kevinjuszczyk/SuperXBit192/kicad/badgesao.step

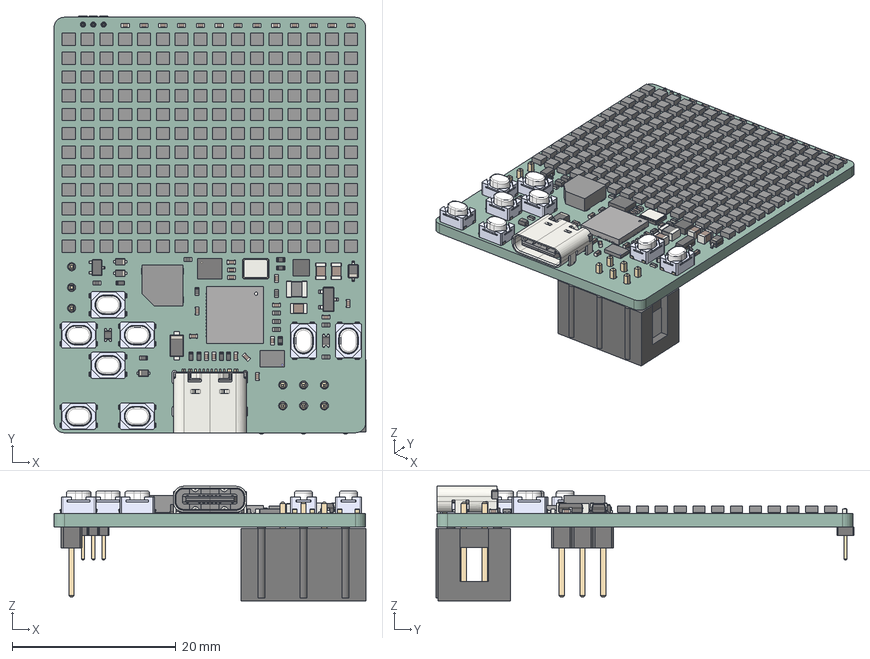
[picture p1: CAD file, 2024-10-02]
kicad/badgesao.step
38.1 x 51.1 x 14.0 mm
ASSEMBLY x 193
C_0402_1005Metric x 28
W25Q80EWUXIE
PTS810SJK250SMTR LFS x 8
R_0402_1005Metric x 18
D_SOD_123F
L_1008_2520Metric
D_SOD_523 x 3
USB_C_Receptacle_16P_TopMnt_Horizontal_GCT_USB4105-xx-A
C_0805_2012Metric x 3
Crystal_SMD_SeikoEpson_FA238-4Pin_3.2x2.5mm
LGA_14_3x25mm_P05mm_LayoutBorder3x4y
SOT_23
TPS61022RWUR
SOT_323_SC_70
QFN_56_1EP_7x7mm_P04mm_EP32x32mm
D_0603 x 2
D_SOD_323
IDC_Header_2x03_P254mm_Vertical
PinHeader_1x03_P254mm_Vertical
PinHeader_1x03_P127mm_Vertical
badgesao_PCB
