kevinjuszczyk/SuperXBit192/kicad/SuperXBit192_schematic.pdf

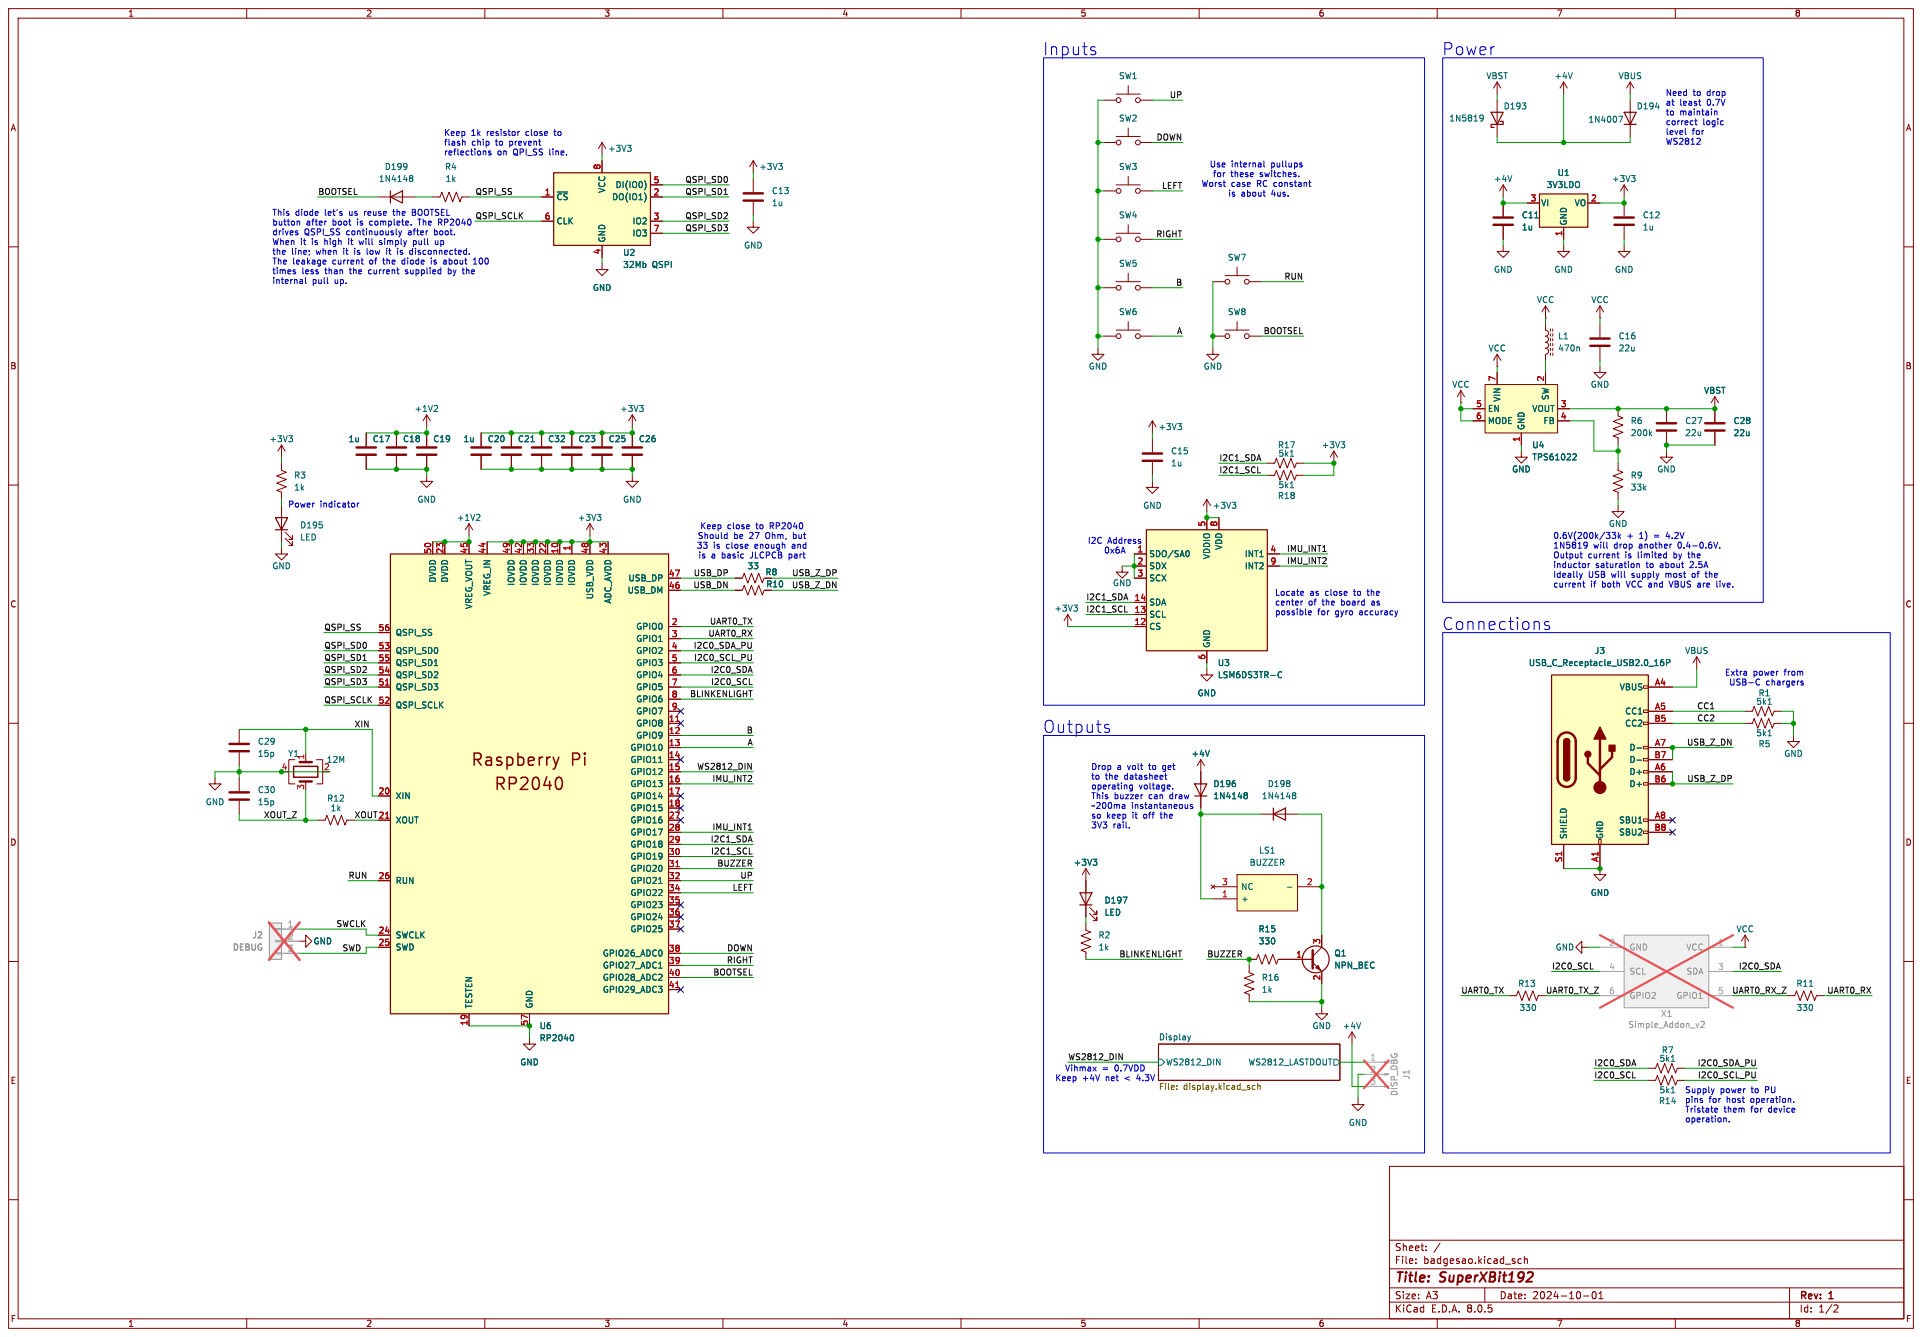
[picture p2: page 1]

Inputs
is about 4us. Locate as close to the
RIGHTB

for these switches. Worst case RC constant

This diode let's us reuse the BOOTSEL

the line; when it is low it is disconnected. The leakage current of the diode is about 100

Ideally USB will supply most of the
current if both VCC and VBUS are live.

~200ma instantaneous
so keep it off the

I2C0_SDA_PU
I2C0_SCL_PU
Supply power to PU
pins for host operation. Tristate them for device
operation.

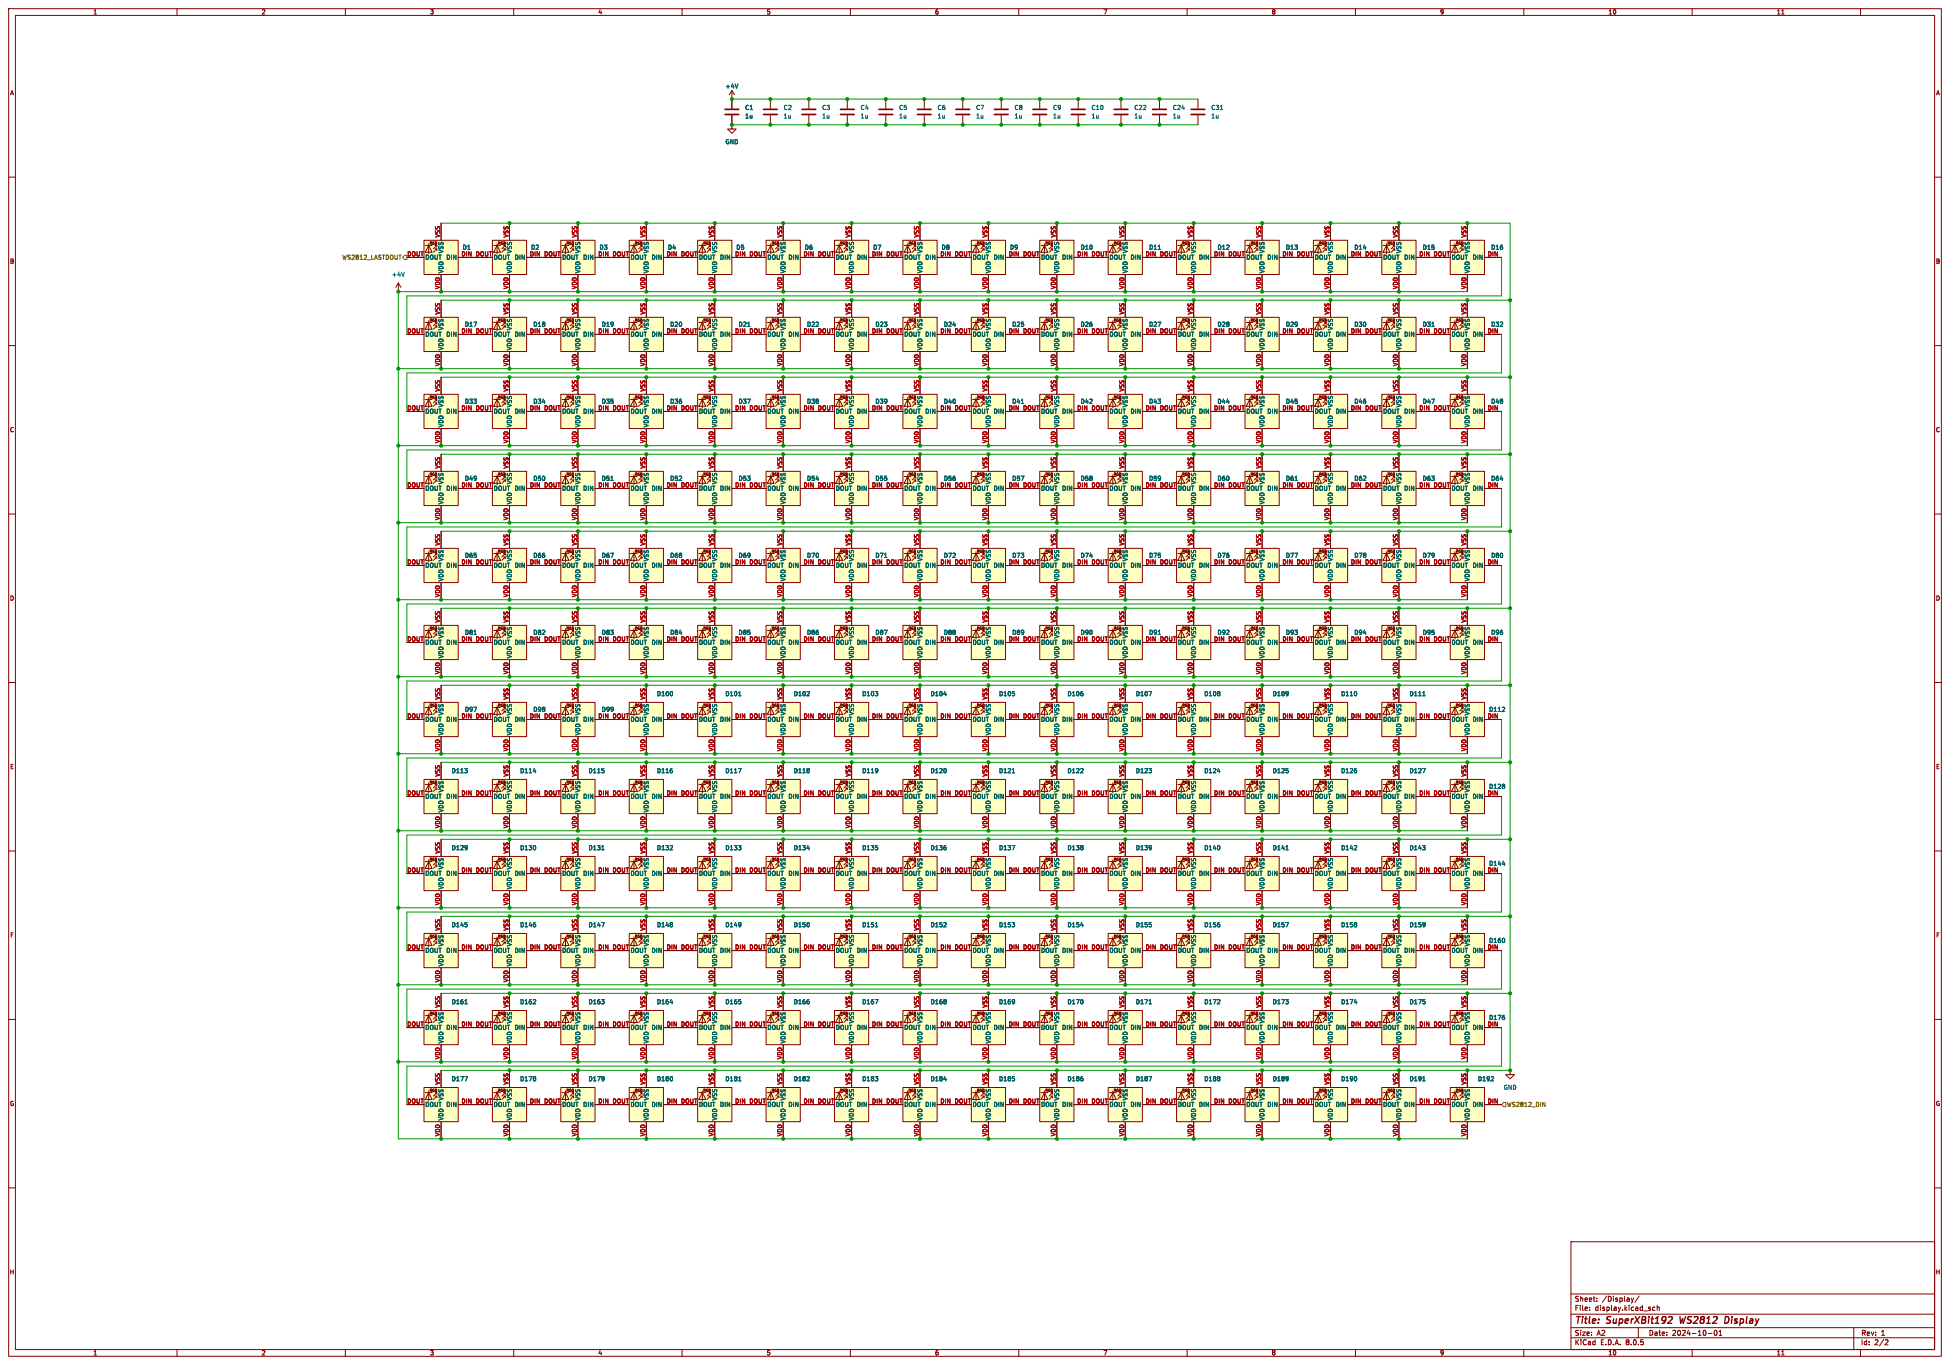
[picture p3: page 2]

File: display.kicad_sch Sheet: /Display/
