kevinjuszczyk/SuperXBit192/kicad/badgesao.kicad_pcb

## KiCad design kicad/badgesao.kicad_pcb (2024-10-02)

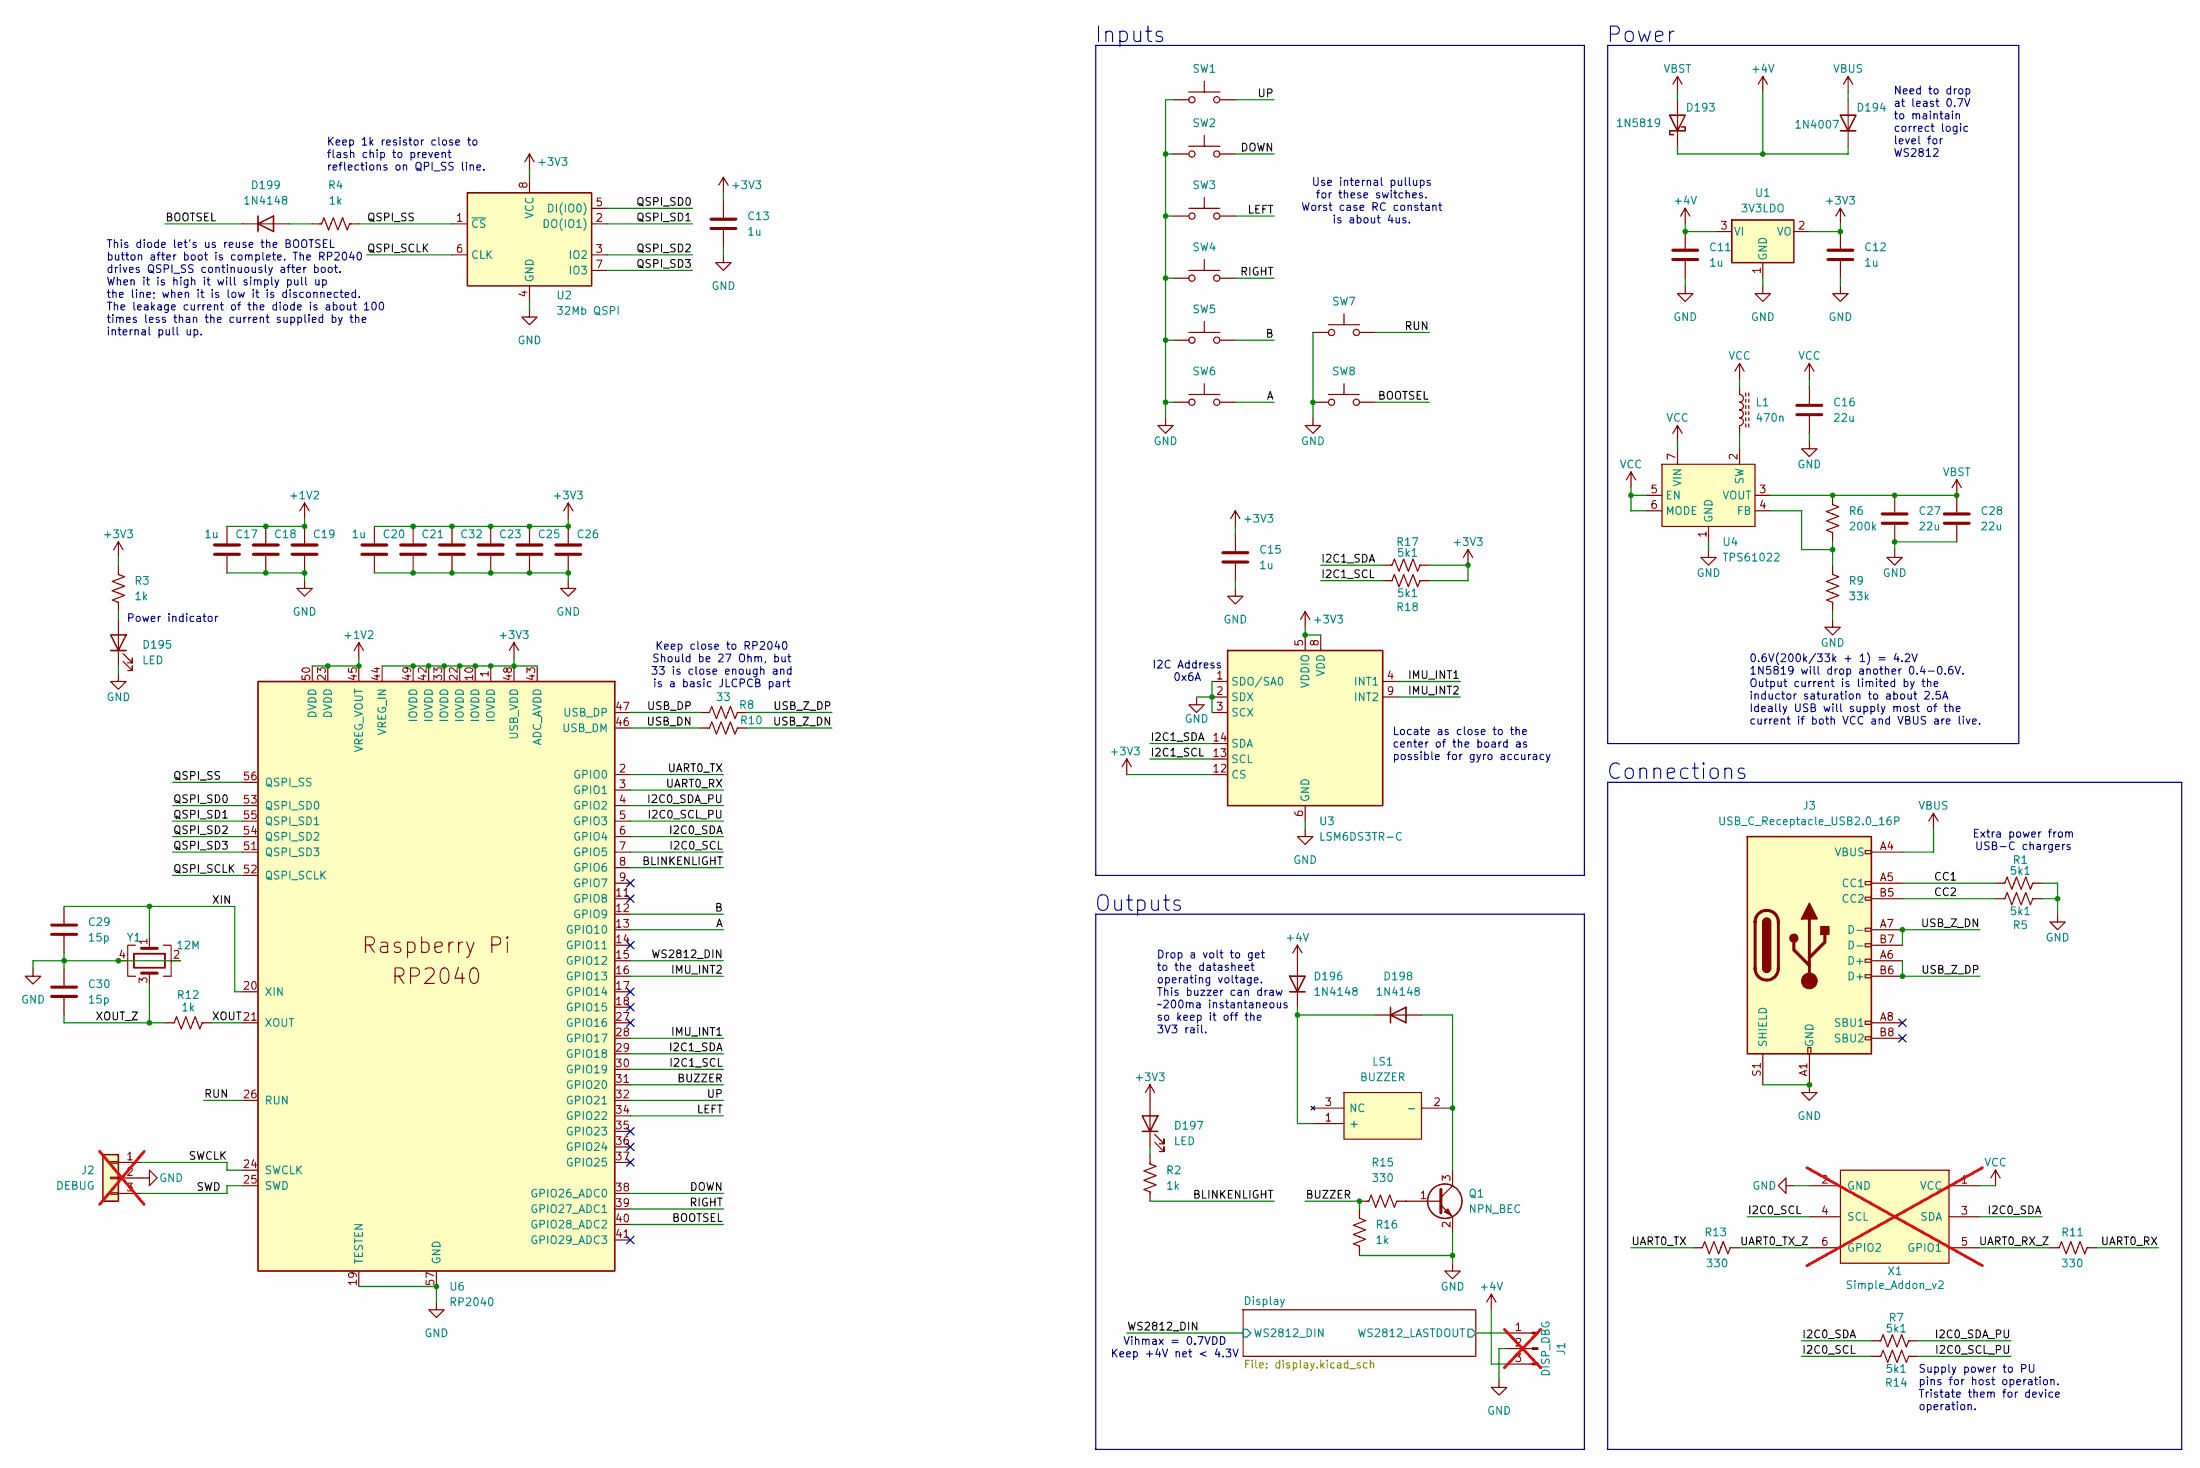
[picture p4: schematic badgesao.kicad_sch, SuperXBit192]

Parts:
C11, C12, C13, C15, C17, C18, C19, C20, C21, C23, C25, C26, C32: 1u; C_0402_1005Metric; Manufacturer_Part_Number CL05A105KA5NQNC; LCSC C52923
C16, C27, C28: 22u; C_0805_2012Metric; Manufacturer_Part_Number CL21A226MAQNNNE; LCSC C45783
C29, C30: 15p; C_0402_1005Metric; Manufacturer_Part_Number 0402CG150J500NT; LCSC C1548
D193: 1N5819; D_SOD-323; Manufacturer_Part_Number 1N5819WS; LCSC C191023
D194: 1N4007; D_SOD-123F; Manufacturer_Part_Number SM4007PL; LCSC C64898
D195, D197: LED; D_0603_1608Metric; Manufacturer_Part_Number KT-0603R; LCSC C2286
D196, D198, D199: 1N4148; D_SOD-523; Manufacturer_Part_Number 1N4148WT; LCSC C7420320
J1: DISP_DBG; PinHeader_1x03_P1.27mm_Vertical; Manufacturer_Part_Number M50-3530342; Digikey_Part 952-3599-ND; not fitted
J2: DEBUG; PinHeader_1x03_P2.54mm_Vertical; Manufacturer_Part_Number 61300311121; Digikey_Part 732-5316-ND; not fitted
J3: USB_C_Receptacle_USB2.0_16P; USB_C_Receptacle_GCT_USB4105-xx-A_16P_TopMnt_Horizontal; Manufacturer_Part_Number U263-163N-4BLS1735; LCSC C2931474
L1: 470n; L_1008_2520Metric; Manufacturer_Part_Number 1239AS-H-R47M=P2; LCSC C576393
LS1: BUZZER; CMT5023SSMTTR; Manufacturer_Part_Number FUET-5020; LCSC C391029
Q1: NPN_BEC; SOT-323_SC-70; Manufacturer_Part_Number MMST3904; LCSC C22388837
R1, R5, R7, R14, R17, R18: 5k1; R_0402_1005Metric; Manufacturer_Part_Number 0402WGF5101TCE; LCSC C25905
R2, R3, R4, R12, R16: 1k; R_0402_1005Metric; Manufacturer_Part_Number 0402WGF1001TCE; LCSC C11702
R6: 200k; R_0402_1005Metric; Manufacturer_Part_Number 0402WGF2003TCE; LCSC C25764
R8, R10: 33; R_0402_1005Metric; Manufacturer_Part_Number 0402WGF330JTCE; LCSC C25105
R9: 33k; R_0402_1005Metric; Manufacturer_Part_Number 0402WGF3302TCE; LCSC C25779
R11, R13, R15: 330; R_0402_1005Metric; Manufacturer_Part_Number 0402WGF3300TCE; LCSC C25104
SW1: UP; SW_SPST_PTS810; Manufacturer_Part_Number PTS815SJM250SMTRLFS; LCSC C2689510
SW2: DOWN; SW_SPST_PTS810; Manufacturer_Part_Number PTS815SJM250SMTRLFS; LCSC C2689510
SW3: LEFT; SW_SPST_PTS810; Manufacturer_Part_Number PTS815SJM250SMTRLFS; LCSC C2689510
SW4: RIGHT; SW_SPST_PTS810; Manufacturer_Part_Number PTS815SJM250SMTRLFS; LCSC C2689510
SW5: B; SW_SPST_PTS810; Manufacturer_Part_Number PTS815SJM250SMTRLFS; LCSC C2689510
SW6: A; SW_SPST_PTS810; Manufacturer_Part_Number PTS815SJM250SMTRLFS; LCSC C2689510
SW7: RESET; SW_SPST_PTS810; Manufacturer_Part_Number PTS815SJM250SMTRLFS; LCSC C2689510
SW8: BOOTSEL; SW_SPST_PTS810; Manufacturer_Part_Number PTS815SJM250SMTRLFS; LCSC C2689510
U1: 3V3LDO; SOT-23; Manufacturer_Part_Number XC6206P332MR-G; LCSC C5446
U2: 32Mb QSPI; Winbond_USON-8-1EP_3x2mm_P0.5mm_EP0.2x1.6mm; Manufacturer_Part_Number ZD25WQ32CEIGR; LCSC C5258281
U3: LSM6DS3TR-C; LGA-14_3x2.5mm_P0.5mm_LayoutBorder3x4y; Manufacturer_Part_Number LSM6DS3TR-C; LCSC C967633
U4: TPS61022; Texas_RWU0007A_VQFN-7_2x2mm_P0.5mm; Manufacturer_Part_Number TPS61022RWUR; LCSC C915088
U6: RP2040; QFN-56-1EP_7x7mm_P0.4mm_EP3.2x3.2mm; Manufacturer_Part_Number RP2040; LCSC C2040
X1: Simple_Addon_v2; Simple_Addon_v2-SAO-2x3; Manufacturer_Part_Number 75869-131LF; Digikey_Part 609-2845-ND; not fitted
Y1: 12M; Crystal_SMD_SeikoEpson_FA238-4Pin_3.2x2.5mm; Manufacturer_Part_Number X322512MSB4SI; LCSC C9002

Connections:
+1V2: C17.1, C18.1, C19.1, U6.23 (DVDD), U6.45 (VREG_VOUT), U6.50 (DVDD)
+3V3: C12.1, C13.1, C15.1, C20.1, C21.1, C23.1, C25.1, C26.1, C32.1, D197.2 (A), R3.2, R17.1, R18.1, U1.2 (VO), U2.8 (VCC), U3.5 (VDDIO), U3.8 (VDD), U3.12 (CS), U6.1 (IOVDD), U6.10 (IOVDD), U6.22 (IOVDD), U6.33 (IOVDD), U6.42 (IOVDD), U6.43 (ADC_AVDD), U6.44 (VREG_IN), U6.48 (USB_VDD), U6.49 (IOVDD)
+4V: C11.1, D193.1 (K), D194.1 (K), D196.2 (A), J1.3, U1.3 (VI); also elsewhere on the board
/A: SW6.2, U6.13 (GPIO10)
/B: SW5.2, U6.12 (GPIO9)
/BLINKENLIGHT: R2.1, U6.8 (GPIO6)
/BOOTSEL: D199.1 (K), SW8.2, U6.40 (GPIO28_ADC2)
/BUZZER: R15.2, R16.2, U6.31 (GPIO20)
/CC1: J3.A5 (CC1), R1.2
/CC2: J3.B5 (CC2), R5.2
/DOWN: SW2.2, U6.38 (GPIO26_ADC0)
/Display/WS2812_LASTDOUT: J1.1; also elsewhere on the board
/I2C0_SCL: R14.2, U6.7 (GPIO5), X1.4 (SCL)
/I2C0_SCL_PU: R14.1, U6.5 (GPIO3)
/I2C0_SDA: R7.2, U6.6 (GPIO4), X1.3 (SDA)
/I2C0_SDA_PU: R7.1, U6.4 (GPIO2)
/I2C1_SCL: R18.2, U3.13 (SCL), U6.30 (GPIO19)
/I2C1_SDA: R17.2, U3.14 (SDA), U6.29 (GPIO18)
/IMU_INT1: U3.4 (INT1), U6.28 (GPIO17)
/IMU_INT2: U3.9 (INT2), U6.16 (GPIO13)
/LEFT: SW3.2, U6.34 (GPIO22)
/QSPI_SCLK: U2.6 (CLK), U6.52 (QSPI_SCLK)
/QSPI_SD0: U2.5 (DI(IO0)), U6.53 (QSPI_SD0)
/QSPI_SD1: U2.2 (DO(IO1)), U6.55 (QSPI_SD1)
/QSPI_SD2: U2.3 (IO2), U6.54 (QSPI_SD2)
/QSPI_SD3: U2.7 (IO3), U6.51 (QSPI_SD3)
/QSPI_SS: R4.1, U2.1 (~CS), U6.56 (QSPI_SS)
/RIGHT: SW4.2, U6.39 (GPIO27_ADC1)
/RUN: SW7.2, U6.26 (RUN)
/SWCLK: J2.1, U6.24 (SWCLK)
/SWD: J2.3, U6.25 (SWD)
/UART0_RX: R11.2, U6.3 (GPIO1)
/UART0_RX_Z: R11.1, X1.5 (GPIO1)
/UART0_TX: R13.1, U6.2 (GPIO0)
/UART0_TX_Z: R13.2, X1.6 (GPIO2)
/UP: SW1.2, U6.32 (GPIO21)
/USB_DN: R10.2, U6.46 (USB_DM)
/USB_DP: R8.2, U6.47 (USB_DP)
/USB_Z_DN: J3.A7 (D-), J3.B7 (D-), R10.1
/USB_Z_DP: J3.A6 (D+), J3.B6 (D+), R8.1
/WS2812_DIN: U6.15 (GPIO12); also elsewhere on the board
/XIN: C29.1, U6.20 (XIN), Y1.1
/XOUT: R12.1, U6.21 (XOUT)
/XOUT_Z: C30.2, R12.2, Y1.3
GND: C11.2, C12.2, C13.2, C15.2, C16.2, C17.2, C18.2, C19.2, C20.2, C21.2, C23.2, C25.2, C26.2, C27.2, C28.2, C29.2, C30.1, C32.2, D195.1 (K), J1.2, J2.2, J3.A1 (GND), J3.A12 (GND), J3.B1 (GND), J3.B12 (GND), J3.S1 (SHIELD), Q1.2 (E), R1.1, R5.1, R9.2, R16.1, SW1.1, SW2.1, SW3.1, SW4.1, SW5.1, SW6.1, SW7.1, SW8.1, U1.1 (GND), U2.4 (GND), U3.1 (SDO/SA0), U3.2 (SDX), U3.3 (SCX), U3.6 (GND), U3.7 (GND), U4.1 (GND), U6.19 (TESTEN), U6.57 (GND), X1.2 (GND), Y1.2, Y1.4; also elsewhere on the board
unnamed: D195.2 (A), R3.1
unnamed: D196.1 (K), D198.1 (K), LS1.1 (+)
unnamed: D197.1 (K), R2.2
unnamed: D198.2 (A), LS1.2 (-), Q1.3 (C)
unnamed: D199.2 (A), R4.2
unnamed: Q1.1 (B), R15.1
unnamed: R6.2, R9.1, U4.4 (FB)
unnamed: L1.2, U4.2 (SW)
VBST: C27.1, C28.1, D193.2 (A), R6.1, U4.3 (VOUT)
VBUS: D194.2 (A), J3.A4 (VBUS), J3.A9 (VBUS), J3.B4 (VBUS), J3.B9 (VBUS)
VCC: C16.1, L1.1, U4.5 (EN), U4.6 (MODE), U4.7 (VIN), X1.1 (VCC)

Notes on the sheet:
This diode let's us reuse the BOOTSEL button after boot is complete. The RP2040 drives QSPI_SS continuously after boot. When it is high it will simply pull up the line; when it is low it is disconnected. The leakage current of the diode is about 100 times less than the current supplied by the inter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
0.6V(200k/33k + 1) = 4.2V 1N5819 will drop another 0.4-0.6V. Output current is limited by the inductor saturation to about 2.5A Ideally USB will supply most of the current if both VCC and VBUS are live.
Need to drop at least 0.7V to maintain correct logic level for WS2812
Inputs
Extra power from USB-C chargers
Connections
Drop a volt to get to the datasheet operating voltage. This buzzer can draw ~200ma instantaneous so keep it off the 3V3 rail.
Power
Supply power to PU pins for host operation. Tristate them for device operation.
Outputs
Power indicator
Vihmax = 0.7VDD Keep +4V net < 4.3V
Keep 1k resistor close to flash chip to prevent reflections on QPI_SS line.
I2C Address 0x6A
Use internal pullups for these switches. Worst case RC constant is about 4us.
Keep close to RP2040 Should be 27 Ohm, but 33 is close enough and is a basic JLCPCB part
Locate as close to the center of the board as possible for gyro accuracy

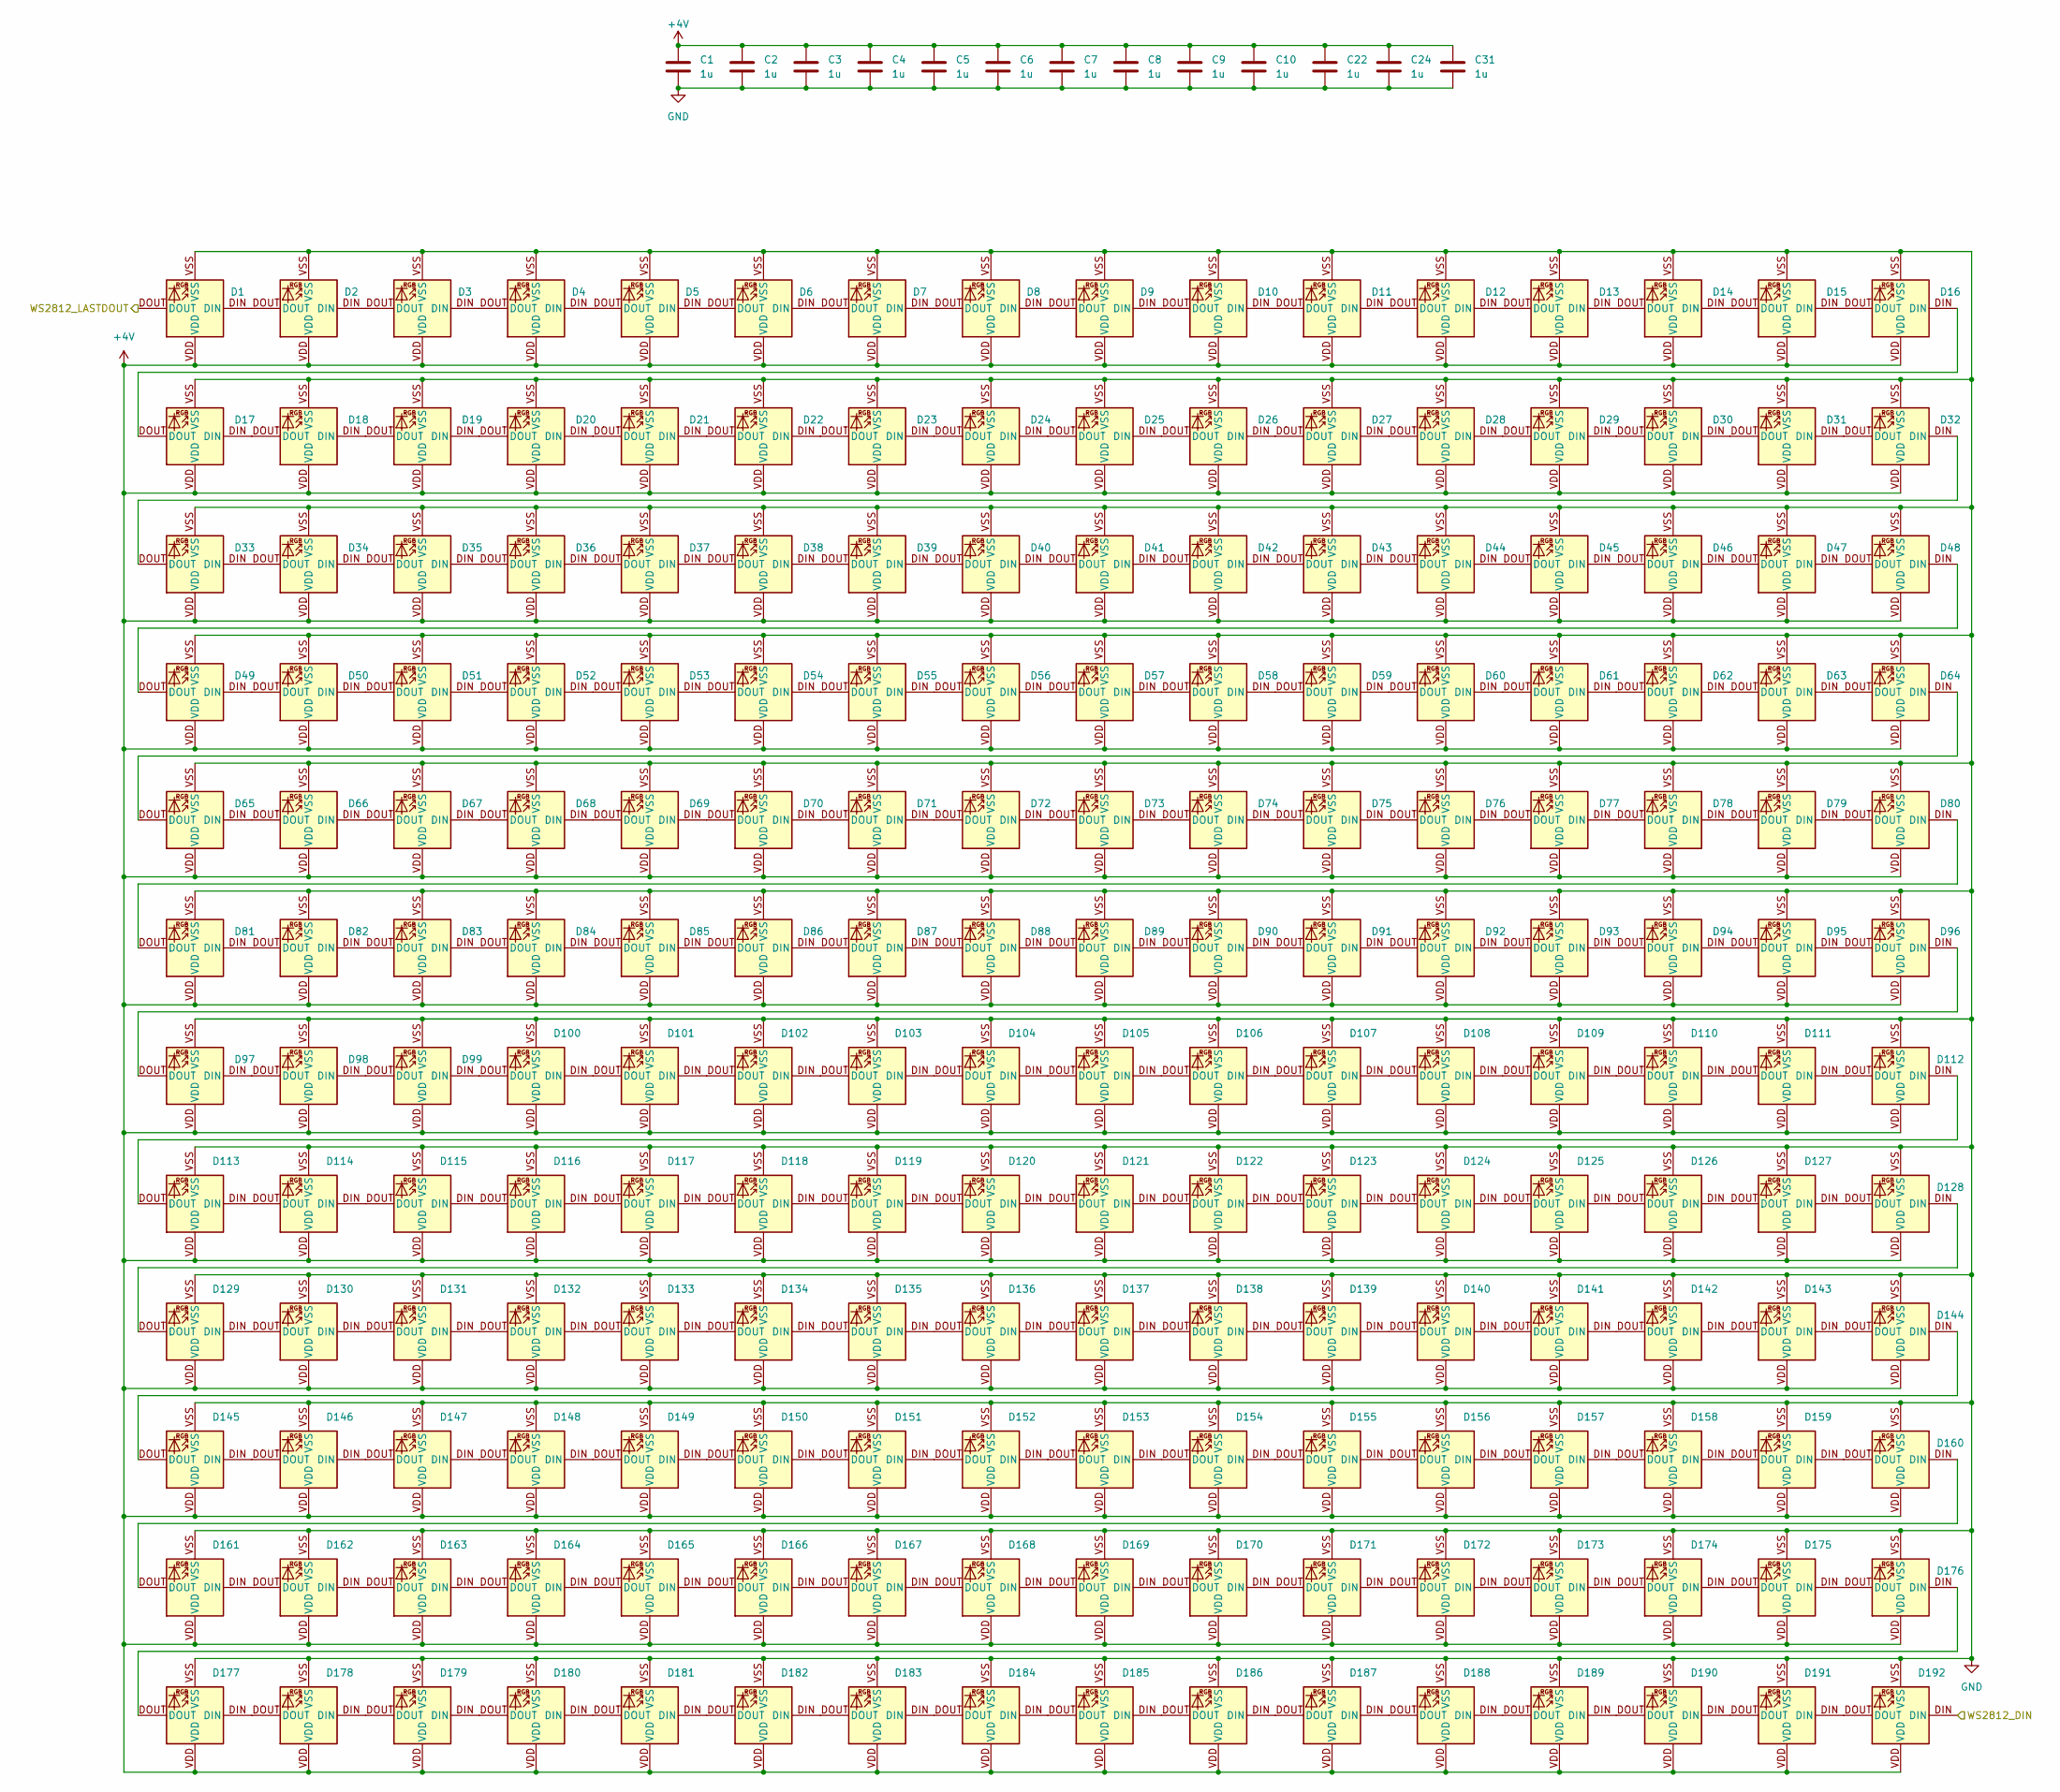
[picture p5: schematic display.kicad_sch, SuperXBit192 WS2812 Display]

Parts:
C1, C2, C3, C4, C5, C6, C7, C8, C9, C10, C22, C24, C31: 1u; C_0402_1005Metric; Manufacturer_Part_Number CL05A105KA5NQNC; LCSC C52923
D1, D2, D3, D4, D5, D6, D7, D8, D9, D10, D11, D12, D13, D14, D15, D16, D17, D18, D19, D20, D21, D22, D23, D24, D25, D26, D27, D28, D29, D30, D31, D32, D33, D34, D35, D36, D37, D38, D39, D40, D41, D42, D43, D44, D45, D46, D47, D48, D49, D50, D51, D52, D53, D54, D55, D56, D57, D58, D59, D60, D61, D62, D63, D64, D65, D66, D67, D68, D69, D70, D71, D72, D73, D74, D75, D76, D77, D78, D79, D80, D81, D82, D83, D84, D85, D86, D87, D88, D89, D90, D91, D92, D93, D94, D95, D96, D97, D98, D99, D100, D101, D102, D103, D104, D105, D106, D107, D108, D109, D110, D111, D112, D113, D114, D115, D116, D117, D118, D119, D120, D121, D122, D123, D124, D125, D126, D127, D128, D129, D130, D131, D132, D133, D134, D135, D136, D137, D138, D139, D140, D141, D142, D143, D144, D145, D146, D147, D148, D149, D150, D151, D152, D153, D154, D155, D156, D157, D158, D159, D160, D161, D162, D163, D164, D165, D166, D167, D168, D169, D170, D171, D172, D173, D174, D175, D176, D177, D178, D179, D180, D181, D182, D183, D184, D185, D186, D187, D188, D189, D190, D191, D192: WS2812B; LED_WS2812B-1615_PLCC4_1.6x1.5mm; Manufacturer_Part_Number XL-1615RGBC-WS2812B; LCSC C5349954

Connections:
+4V: C1.1, C2.1, C3.1, C4.1, C5.1, C6.1, C7.1, C8.1, C9.1, C10.1, C22.1, C24.1, C31.1, D1.VDD, D2.VDD, D3.VDD, D4.VDD, D5.VDD, D6.VDD, D7.VDD, D8.VDD, D9.VDD, D10.VDD, D11.VDD, D12.VDD, D13.VDD, D14.VDD, D15.VDD, D16.VDD, D17.VDD, D18.VDD, D19.VDD, D20.VDD, D21.VDD, D22.VDD, D23.VDD, D24.VDD, D25.VDD, D26.VDD, D27.VDD, D28.VDD, D29.VDD, D30.VDD, D31.VDD, D32.VDD, D33.VDD, D34.VDD, D35.VDD, D36.VDD, D37.VDD, D38.VDD, D39.VDD, D40.VDD, D41.VDD, D42.VDD, D43.VDD, D44.VDD, D45.VDD, D46.VDD, D47.VDD, D48.VDD, D49.VDD, D50.VDD, D51.VDD, D52.VDD, D53.VDD, D54.VDD, D55.VDD, D56.VDD, D57.VDD, D58.VDD, D59.VDD, D60.VDD, D61.VDD, D62.VDD, D63.VDD, D64.VDD, D65.VDD, D66.VDD, D67.VDD, D68.VDD, D69.VDD, D70.VDD, D71.VDD, D72.VDD, D73.VDD, D74.VDD, D75.VDD, D76.VDD, D77.VDD, D78.VDD, D79.VDD, D80.VDD, D81.VDD, D82.VDD, D83.VDD, D84.VDD, D85.VDD, D86.VDD, D87.VDD, D88.VDD, D89.VDD, D90.VDD, D91.VDD, D92.VDD, D93.VDD, D94.VDD, D95.VDD, D96.VDD, D97.VDD, D98.VDD, D99.VDD, D100.VDD, D101.VDD, D102.VDD, D103.VDD, D104.VDD, D105.VDD, D106.VDD, D107.VDD, D108.VDD, D109.VDD, D110.VDD, D111.VDD, D112.VDD, D113.VDD, D114.VDD, D115.VDD, D116.VDD, D117.VDD, D118.VDD, D119.VDD, D120.VDD, D121.VDD, D122.VDD, D123.VDD, D124.VDD, D125.VDD, D126.VDD, D127.VDD, D128.VDD, D129.VDD, D130.VDD, D131.VDD, D132.VDD, D133.VDD, D134.VDD, D135.VDD, D136.VDD, D137.VDD, D138.VDD, D139.VDD, D140.VDD, D141.VDD, D142.VDD, D143.VDD, D144.VDD, D145.VDD, D146.VDD, D147.VDD, D148.VDD, D149.VDD, D150.VDD, D151.VDD, D152.VDD, D153.VDD, D154.VDD, D155.VDD, D156.VDD, D157.VDD, D158.VDD, D159.VDD, D160.VDD, D161.VDD, D162.VDD, D163.VDD, D164.VDD, D165.VDD, D166.VDD, D167.VDD, D168.VDD, D169.VDD, D170.VDD, D171.VDD, D172.VDD, D173.VDD, D174.VDD, D175.VDD, D176.VDD, D177.VDD, D178.VDD, D179.VDD, D180.VDD, D181.VDD, D182.VDD, D183.VDD, D184.VDD, D185.VDD, D186.VDD, D187.VDD, D188.VDD, D189.VDD, D190.VDD, D191.VDD, D192.VDD; also elsewhere on the board
/Display/WS2812_LASTDOUT: D1.DOUT; also elsewhere on the board
/WS2812_DIN: D192.DIN; also elsewhere on the board
GND: C1.2, C2.2, C3.2, C4.2, C5.2, C6.2, C7.2, C8.2, C9.2, C10.2, C22.2, C24.2, C31.2, D1.VSS, D2.VSS, D3.VSS, D4.VSS, D5.VSS, D6.VSS, D7.VSS, D8.VSS, D9.VSS, D10.VSS, D11.VSS, D12.VSS, D13.VSS, D14.VSS, D15.VSS, D16.VSS, D17.VSS, D18.VSS, D19.VSS, D20.VSS, D21.VSS, D22.VSS, D23.VSS, D24.VSS, D25.VSS, D26.VSS, D27.VSS, D28.VSS, D29.VSS, D30.VSS, D31.VSS, D32.VSS, D33.VSS, D34.VSS, D35.VSS, D36.VSS, D37.VSS, D38.VSS, D39.VSS, D40.VSS, D41.VSS, D42.VSS, D43.VSS, D44.VSS, D45.VSS, D46.VSS, D47.VSS, D48.VSS, D49.VSS, D50.VSS, D51.VSS, D52.VSS, D53.VSS, D54.VSS, D55.VSS, D56.VSS, D57.VSS, D58.VSS, D59.VSS, D60.VSS, D61.VSS, D62.VSS, D63.VSS, D64.VSS, D65.VSS, D66.VSS, D67.VSS, D68.VSS, D69.VSS, D70.VSS, D71.VSS, D72.VSS, D73.VSS, D74.VSS, D75.VSS, D76.VSS, D77.VSS, D78.VSS, D79.VSS, D80.VSS, D81.VSS, D82.VSS, D83.VSS, D84.VSS, D85.VSS, D86.VSS, D87.VSS, D88.VSS, D89.VSS, D90.VSS, D91.VSS, D92.VSS, D93.VSS, D94.VSS, D95.VSS, D96.VSS, D97.VSS, D98.VSS, D99.VSS, D100.VSS, D101.VSS, D102.VSS, D103.VSS, D104.VSS, D105.VSS, D106.VSS, D107.VSS, D108.VSS, D109.VSS, D110.VSS, D111.VSS, D112.VSS, D113.VSS, D114.VSS, D115.VSS, D116.VSS, D117.VSS, D118.VSS, D119.VSS, D120.VSS, D121.VSS, D122.VSS, D123.VSS, D124.VSS, D125.VSS, D126.VSS, D127.VSS, D128.VSS, D129.VSS, D130.VSS, D131.VSS, D132.VSS, D133.VSS, D134.VSS, D135.VSS, D136.VSS, D137.VSS, D138.VSS, D139.VSS, D140.VSS, D141.VSS, D142.VSS, D143.VSS, D144.VSS, D145.VSS, D146.VSS, D147.VSS, D148.VSS, D149.VSS, D150.VSS, D151.VSS, D152.VSS, D153.VSS, D154.VSS, D155.VSS, D156.VSS, D157.VSS, D158.VSS, D159.VSS, D160.VSS, D161.VSS, D162.VSS, D163.VSS, D164.VSS, D165.VSS, D166.VSS, D167.VSS, D168.VSS, D169.VSS, D170.VSS, D171.VSS, D172.VSS, D173.VSS, D174.VSS, D175.VSS, D176.VSS, D177.VSS, D178.VSS, D179.VSS, D180.VSS, D181.VSS, D182.VSS, D183.VSS, D184.VSS, D185.VSS, D186.VSS, D187.VSS, D188.VSS, D189.VSS, D190.VSS, D191.VSS, D192.VSS; also elsewhere on the board
unnamed: D1.DIN, D2.DOUT
unnamed: D2.DIN, D3.DOUT
unnamed: D3.DIN, D4.DOUT
unnamed: D4.DIN, D5.DOUT
unnamed: D5.DIN, D6.DOUT
unnamed: D6.DIN, D7.DOUT
unnamed: D7.DIN, D8.DOUT
unnamed: D8.DIN, D9.DOUT
unnamed: D10.DIN, D11.DOUT
unnamed: D9.DIN, D10.DOUT
unnamed: D11.DIN, D12.DOUT
unnamed: D12.DIN, D13.DOUT
unnamed: D13.DIN, D14.DOUT
unnamed: D14.DIN, D15.DOUT
unnamed: D15.DIN, D16.DOUT
unnamed: D16.DIN, D17.DOUT
unnamed: D17.DIN, D18.DOUT
unnamed: D18.DIN, D19.DOUT
unnamed: D19.DIN, D20.DOUT
unnamed: D20.DIN, D21.DOUT
unnamed: D21.DIN, D22.DOUT
unnamed: D22.DIN, D23.DOUT
unnamed: D23.DIN, D24.DOUT
unnamed: D24.DIN, D25.DOUT
unnamed: D25.DIN, D26.DOUT
unnamed: D26.DIN, D27.DOUT
unnamed: D27.DIN, D28.DOUT
unnamed: D28.DIN, D29.DOUT
unnamed: D29.DIN, D30.DOUT
unnamed: D30.DIN, D31.DOUT
unnamed: D31.DIN, D32.DOUT
unnamed: D32.DIN, D33.DOUT
unnamed: D33.DIN, D34.DOUT
unnamed: D34.DIN, D35.DOUT
unnamed: D35.DIN, D36.DOUT
unnamed: D36.DIN, D37.DOUT
unnamed: D37.DIN, D38.DOUT
unnamed: D38.DIN, D39.DOUT
unnamed: D39.DIN, D40.DOUT
unnamed: D40.DIN, D41.DOUT
unnamed: D41.DIN, D42.DOUT
unnamed: D42.DIN, D43.DOUT
unnamed: D43.DIN, D44.DOUT
unnamed: D44.DIN, D45.DOUT
unnamed: D45.DIN, D46.DOUT
unnamed: D46.DIN, D47.DOUT
unnamed: D47.DIN, D48.DOUT
unnamed: D48.DIN, D49.DOUT
unnamed: D49.DIN, D50.DOUT
unnamed: D50.DIN, D51.DOUT
unnamed: D51.DIN, D52.DOUT
unnamed: D52.DIN, D53.DOUT
unnamed: D53.DIN, D54.DOUT
unnamed: D54.DIN, D55.DOUT
unnamed: D55.DIN, D56.DOUT
unnamed: D56.DIN, D57.DOUT
unnamed: D57.DIN, D58.DOUT
unnamed: D58.DIN, D59.DOUT
unnamed: D59.DIN, D60.DOUT
unnamed: D60.DIN, D61.DOUT
unnamed: D61.DIN, D62.DOUT
unnamed: D62.DIN, D63.DOUT
unnamed: D63.DIN, D64.DOUT
unnamed: D64.DIN, D65.DOUT
unnamed: D65.DIN, D66.DOUT
unnamed: D66.DIN, D67.DOUT
unnamed: D67.DIN, D68.DOUT
unnamed: D68.DIN, D69.DOUT
unnamed: D69.DIN, D70.DOUT
unnamed: D70.DIN, D71.DOUT
unnamed: D71.DIN, D72.DOUT
unnamed: D72.DIN, D73.DOUT
unnamed: D73.DIN, D74.DOUT
unnamed: D74.DIN, D75.DOUT
unnamed: D75.DIN, D76.DOUT
unnamed: D76.DIN, D77.DOUT
unnamed: D77.DIN, D78.DOUT
unnamed: D78.DIN, D79.DOUT
unnamed: D79.DIN, D80.DOUT
unnamed: D80.DIN, D81.DOUT
unnamed: D81.DIN, D82.DOUT
unnamed: D82.DIN, D83.DOUT
unnamed: D83.DIN, D84.DOUT
unnamed: D84.DIN, D85.DOUT
unnamed: D85.DIN, D86.DOUT
unnamed: D86.DIN, D87.DOUT
unnamed: D87.DIN, D88.DOUT
unnamed: D88.DIN, D89.DOUT
unnamed: D89.DIN, D90.DOUT
unnamed: D90.DIN, D91.DOUT
unnamed: D91.DIN, D92.DOUT
unnamed: D92.DIN, D93.DOUT
unnamed: D93.DIN, D94.DOUT
unnamed: D94.DIN, D95.DOUT
unnamed: D95.DIN, D96.DOUT
unnamed: D96.DIN, D97.DOUT
unnamed: D97.DIN, D98.DOUT
unnamed: D98.DIN, D99.DOUT
unnamed: D100.DIN, D101.DOUT
unnamed: D99.DIN, D100.DOUT
unnamed: D101.DIN, D102.DOUT
unnamed: D102.DIN, D103.DOUT
unnamed: D103.DIN, D104.DOUT
unnamed: D104.DIN, D105.DOUT
unnamed: D105.DIN, D106.DOUT
unnamed: D106.DIN, D107.DOUT
unnamed: D107.DIN, D108.DOUT
unnamed: D108.DIN, D109.DOUT
unnamed: D109.DIN, D110.DOUT
unnamed: D110.DIN, D111.DOUT
unnamed: D111.DIN, D112.DOUT
unnamed: D112.DIN, D113.DOUT
unnamed: D113.DIN, D114.DOUT
unnamed: D114.DIN, D115.DOUT
unnamed: D115.DIN, D116.DOUT
unnamed: D116.DIN, D117.DOUT
unnamed: D117.DIN, D118.DOUT
unnamed: D118.DIN, D119.DOUT
unnamed: D119.DIN, D120.DOUT
unnamed: D120.DIN, D121.DOUT
unnamed: D121.DIN, D122.DOUT
unnamed: D122.DIN, D123.DOUT
unnamed: D123.DIN, D124.DOUT
unnamed: D124.DIN, D125.DOUT
unnamed: D125.DIN, D126.DOUT
unnamed: D126.DIN, D127.DOUT
unnamed: D127.DIN, D128.DOUT
unnamed: D128.DIN, D129.DOUT
unnamed: D129.DIN, D130.DOUT
unnamed: D130.DIN, D131.DOUT
unnamed: D131.DIN, D132.DOUT
unnamed: D132.DIN, D133.DOUT
unnamed: D133.DIN, D134.DOUT
unnamed: D134.DIN, D135.DOUT
unnamed: D135.DIN, D136.DOUT
unnamed: D136.DIN, D137.DOUT
unnamed: D137.DIN, D138.DOUT
unnamed: D138.DIN, D139.DOUT
unnamed: D139.DIN, D140.DOUT
unnamed: D140.DIN, D141.DOUT
unnamed: D141.DIN, D142.DOUT
unnamed: D142.DIN, D143.DOUT
unnamed: D143.DIN, D144.DOUT
unnamed: D144.DIN, D145.DOUT
unnamed: D145.DIN, D146.DOUT
unnamed: D146.DIN, D147.DOUT
unnamed: D147.DIN, D148.DOUT
unnamed: D148.DIN, D149.DOUT
unnamed: D149.DIN, D150.DOUT
unnamed: D150.DIN, D151.DOUT
unnamed: D151.DIN, D152.DOUT
unnamed: D152.DIN, D153.DOUT
unnamed: D153.DIN, D154.DOUT
unnamed: D154.DIN, D155.DOUT
unnamed: D155.DIN, D156.DOUT
unnamed: D156.DIN, D157.DOUT
unnamed: D157.DIN, D158.DOUT
unnamed: D158.DIN, D159.DOUT
unnamed: D159.DIN, D160.DOUT
unnamed: D160.DIN, D161.DOUT
unnamed: D161.DIN, D162.DOUT
unnamed: D162.DIN, D163.DOUT
unnamed: D163.DIN, D164.DOUT
unnamed: D164.DIN, D165.DOUT
unnamed: D165.DIN, D166.DOUT
unnamed: D166.DIN, D167.DOUT
unnamed: D167.DIN, D168.DOUT
unnamed: D168.DIN, D169.DOUT
unnamed: D169.DIN, D170.DOUT
unnamed: D170.DIN, D171.DOUT
unnamed: D171.DIN, D172.DOUT
unnamed: D172.DIN, D173.DOUT
unnamed: D173.DIN, D174.DOUT
unnamed: D174.DIN, D175.DOUT
unnamed: D175.DIN, D176.DOUT
unnamed: D176.DIN, D177.DOUT
unnamed: D177.DIN, D178.DOUT
unnamed: D178.DIN, D179.DOUT
unnamed: D179.DIN, D180.DOUT
unnamed: D180.DIN, D181.DOUT
unnamed: D181.DIN, D182.DOUT
unnamed: D182.DIN, D183.DOUT
unnamed: D183.DIN, D184.DOUT
unnamed: D184.DIN, D185.DOUT
unnamed: D185.DIN, D186.DOUT
unnamed: D186.DIN, D187.DOUT
unnamed: D187.DIN, D188.DOUT
unnamed: D188.DIN, D189.DOUT
unnamed: D189.DIN, D190.DOUT
unnamed: D190.DIN, D191.DOUT
unnamed: D191.DIN, D192.DOUT

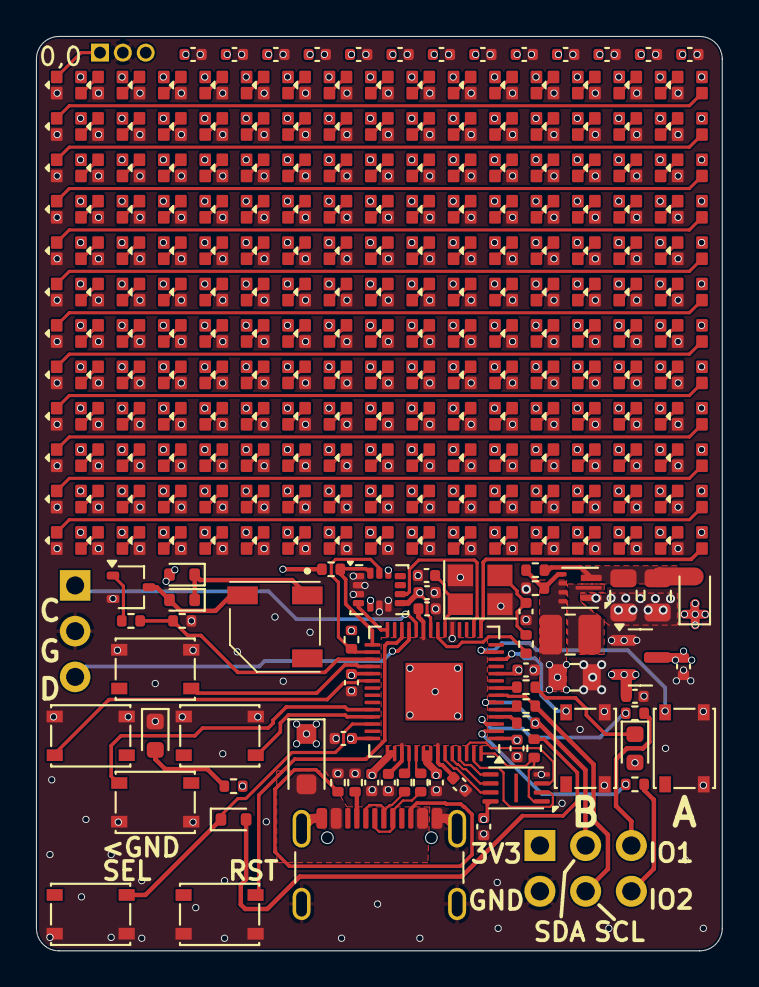
[picture p6: board badgesao.kicad_pcb from above]

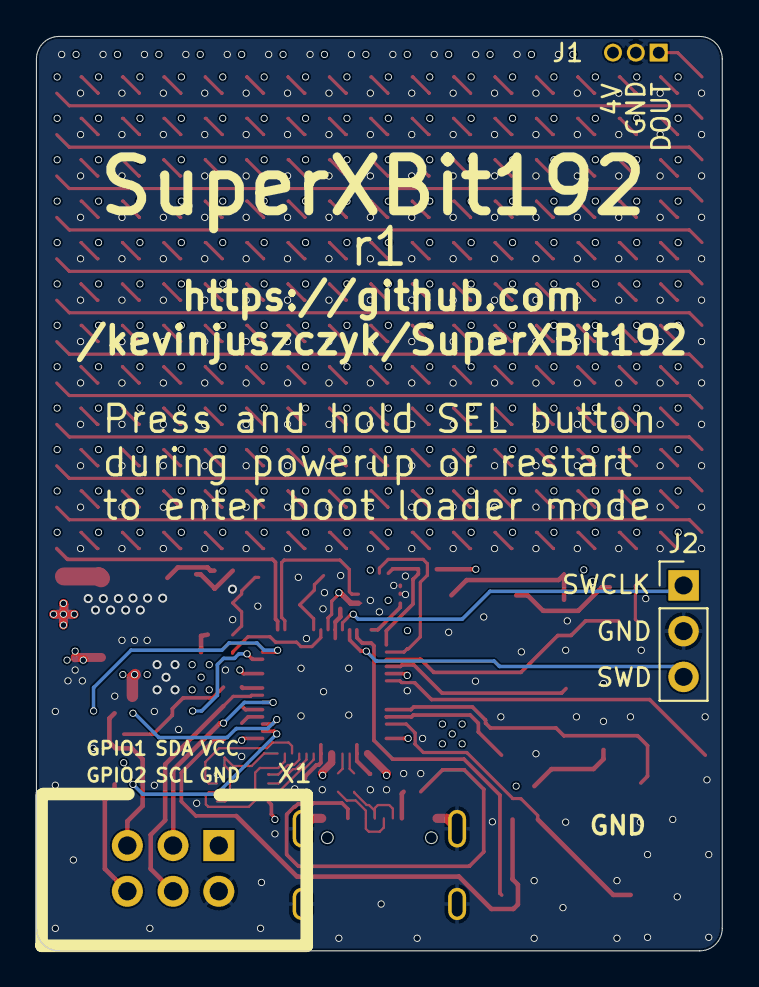
[picture p7: board badgesao.kicad_pcb from below]

Board: 6 copper layers, 38.1 x 50.8 mm, 269 parts (2 on the bottom side), 247 nets.
