kevinjuszczyk/SuperXBit192/(commit log)

2024-09-22 connected buzzer and sel nets
    [badgesao.kicad_pcb, badgesao.kicad_sch]
2024-10-02 fixed all rev0 issues
    connected buzzer and bootsel nets
    changed IMU to I2C mode
    changed IMU to the cheaper -C model
    changed all buttons to PTS815
    changed order of WS2812s so that the frame buffer can be shifted monolithically
    changed boost converter feedback network to use JLCPCB basic parts
    [badgesao-CuBottom.gbr, badgesao-CuIn1.gbr, badgesao-CuIn2.gbr, badgesao-CuIn3.gbr, badgesao-CuIn4.gbr, badgesao-CuTop.gbr, badgesao-EdgeCuts.gbr, badgesao-MaskBottom.gbr]
2024-10-15 demo updates for rev1, kicad exports
    [BOM-badgesao.csv, SuperXBit192_bom.csv, jlcpcb_settings.csv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]
2024-10-18 imu graphic
2024-10-22 imusand demo
